olofos/servo-joystick/pwm.asc

R1: res; 46.25k
R2: res; 24k
R3: res; 100k
R4: res; 100k
R5: res; 33
R6: res; 1
U1: LTC6240
U2: LTC6240
V1: voltage; 5
V2: voltage; 5
V3: voltage; PULSE(1.5 3.5 0 0.012 0.012 1e-10 0.024 100)
Named nets: 0
.tran 100ms
