olofos/servo-joystick/servo-joystick.kicad_pcb

## KiCad design servo-joystick.kicad_pcb (2018-06-14)

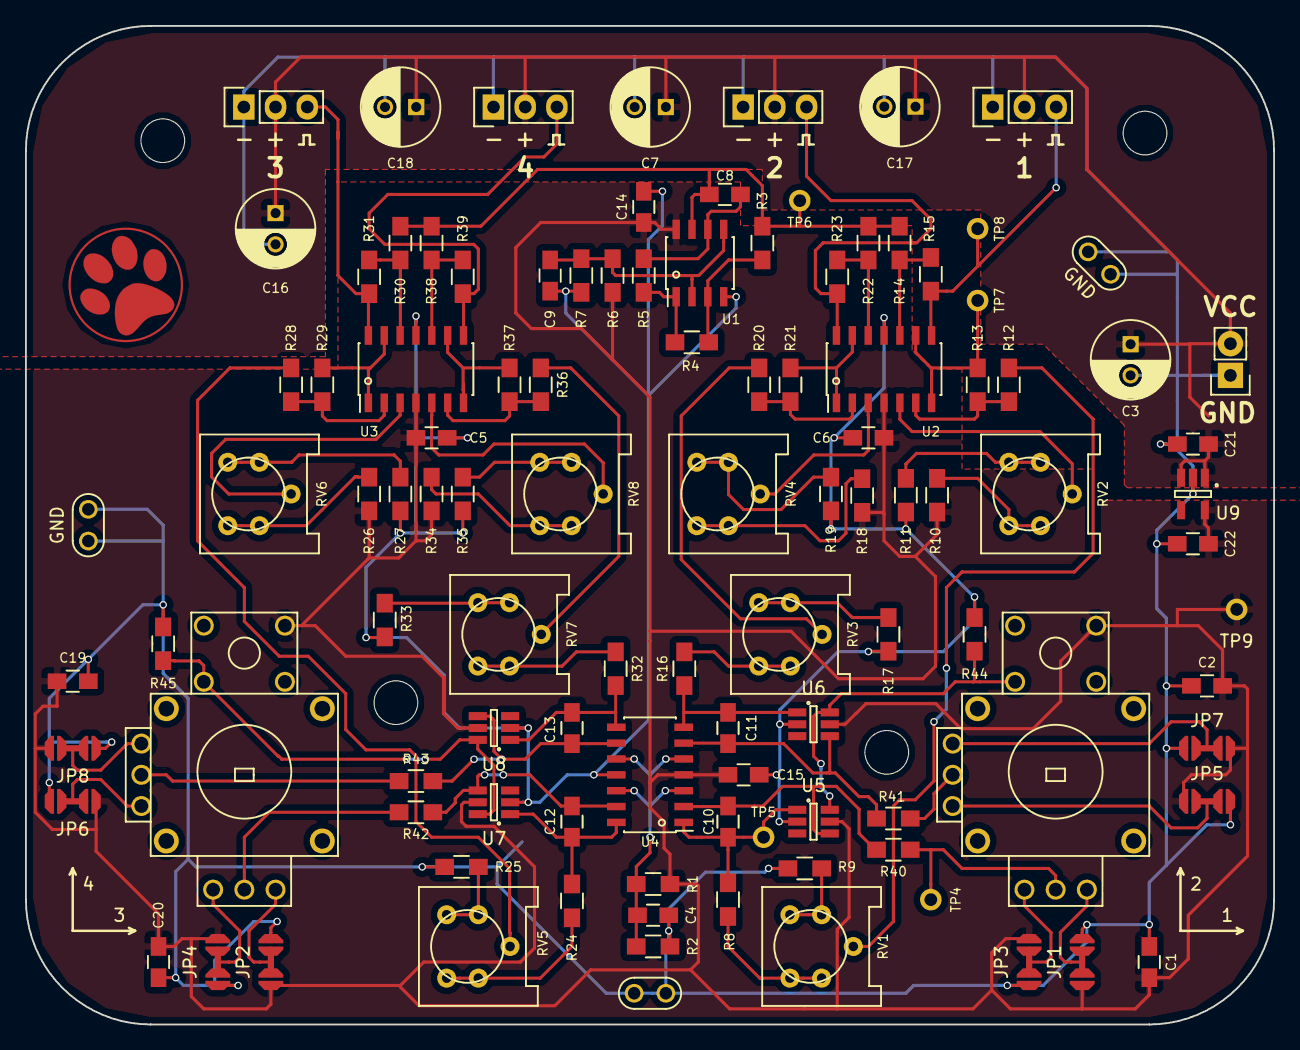
[picture p1: board servo-joystick.kicad_pcb from above]

Board: 2 copper layers, 100.0 x 80.0 mm, 112 parts (0 on the bottom side), 71 nets.

Parts:
C1, C2, C4, C5, C6, C9, C14, C15, C19, C20: 1u; C_0805_HandSoldering
C3, C7, C16, C17, C18: 100u; C_Radial_D6.3_L11.2_P2.5
C8, C10, C11, C12, C13: 100n; C_0805_HandSoldering
C21, C22: 2u2; C_0805_HandSoldering
JP1, JP2, JP3, JP4, JP5, JP6, JP7, JP8: JUMPER-3
MH6, MH6#2, MH6#3, MH6#4: MOUNTING_HOLE; MH-M3
P1: CONN_01X02; Pin_Header_Straight_1x02
P2, P3, P4, P5: CONN_01X03; Pin_Header_Straight_1x03
R1, R2, R3, R6, R7, R44, R45: 1k2; R_0805_HandSoldering
R4: 3k; R_0805_HandSoldering
R5, R12, R13, R15, R20, R21, R23, R28, R29, R31, R36, R37, R39: 150k; R_0805_HandSoldering
R8, R10, R16, R18, R24, R26, R32, R34: 30k; R_0805_HandSoldering
R9, R14, R17, R22, R25, R30, R33, R38: 470; R_0805_HandSoldering
R11, R19, R27, R35: 15k; R_0805_HandSoldering
R40, R41, R42, R43: 6M8; R_0805_HandSoldering
RV1, RV3, RV5, RV7: 100; Potentiometer_Bourns_3386P
RV2, RV4, RV6, RV8: 1k; Potentiometer_Bourns_3386P
TP1, TP2, TP3: GND; TEST_POINT_DOUBLE_TH
TP4: CTRL1; TEST_POINT_THD_NO_CIRC
TP5: INT1; TEST_POINT_THD_NO_CIRC
TP6: SAW; TEST_POINT_THD_NO_CIRC
TP7: BUF1; TEST_POINT_THD_NO_CIRC
TP8: PWM1; TEST_POINT_THD_NO_CIRC
TP9: VCC; TEST_POINT_THD_NO_CIRC
U1: MCP6002; SOIC-8_3.9x4.9mm_Pitch1.27mm
U2, U3, U4: MCP6004; SOIC-14_3.9x8.7mm_Pitch1.27mm
U5, U6, U7, U8: SN74LVC1G3157; SOT-23-6-Handsoldering
U9: LD2981; SOT-23-5-Handsoldering
VR1, VR2: JOYSTICK_SW; F-JM10K

Connections:
+6V: C3.1, C7.1, C16.1, C17.1, C18.1, C21.1, P1.2, P2.2, P3.2, P4.2, P5.2, U9.1, U9.3
/Integrator #1/INT_FB: C10.2, R40.1, U4.2, U5.4
/Integrator #1/SW: R44.2, U5.6, U6.6, VR1.7
/Integrator #1/VIN: R40.2, TP4.1, VR1.2
/Integrator #1/VREF: C4.1, R1.2, R2.1, U4.3, U4.5, U4.10, U4.12
/Integrator #2/INT_FB: C11.2, R41.1, U4.6, U6.4
/Integrator #2/VIN: R41.2, VR1.5
/Integrator #3/INT_FB: C12.2, R42.1, U4.13, U7.4
/Integrator #3/SW: R45.2, U7.6, U8.6, VR2.7
/Integrator #3/VIN: R42.2, VR2.2
/Integrator #4/INT_FB: C13.2, R43.1, U4.9, U8.4
/Integrator #4/VIN: R43.2, VR2.5
/PWM #1/BUF: R13.1, TP7.1, U2.7, U2.9
/PWM #1/BUF_IN: R12.1, R13.2, U2.6
/PWM #1/PWM: P2.3, R15.1, TP8.1, U2.8
/PWM #1/SAWTOOTH: C8.1, R3.2, R14.2, R22.2, R30.2, R38.2, TP6.1, U1.7
/PWM #1/SAW_P: R14.1, R15.2, U2.10
/PWM #1/VIN: C10.1, R8.1, TP5.1, U4.1, U5.1
/PWM #1/VIN_ADJ_M: R9.1, RV1.3
/PWM #1/VIN_ADJ_P: R8.2, RV1.1
/PWM #1/VIN_DIV: R12.2, RV1.2
/PWM #1/VREF: RV2.2, U2.5
/PWM #1/VREF_ADJ_M: R11.1, RV2.3
/PWM #1/VREF_ADJ_P: R10.2, RV2.1
/PWM #2/BUF: R21.1, U2.1, U2.13
/PWM #2/BUF_IN: R20.1, R21.2, U2.2
/PWM #2/PWM: P3.3, R23.1, U2.14
/PWM #2/SAW_P: R22.1, R23.2, U2.12
/PWM #2/VIN: C11.1, R16.1, U4.7, U6.1
/PWM #2/VIN_ADJ_M: R17.1, RV3.3
/PWM #2/VIN_ADJ_P: R16.2, RV3.1
/PWM #2/VIN_DIV: R20.2, RV3.2
/PWM #2/VREF: RV4.2, U2.3
/PWM #2/VREF_ADJ_M: R19.1, RV4.3
/PWM #2/VREF_ADJ_P: R18.2, RV4.1
/PWM #3/BUF: R29.1, U3.1, U3.13
/PWM #3/BUF_IN: R28.1, R29.2, U3.2
/PWM #3/PWM: P4.3, R31.1, U3.14
/PWM #3/SAW_P: R30.1, R31.2, U3.12
/PWM #3/VIN: C12.1, R24.1, U4.14, U7.1
/PWM #3/VIN_ADJ_M: R25.1, RV5.3
/PWM #3/VIN_ADJ_P: R24.2, RV5.1
/PWM #3/VIN_DIV: R28.2, RV5.2
/PWM #3/VREF: RV6.2, U3.3
/PWM #3/VREF_ADJ_M: R27.1, RV6.3
/PWM #3/VREF_ADJ_P: R26.2, RV6.1
/PWM #4/BUF: R37.1, U3.7, U3.9
/PWM #4/BUF_IN: R36.1, R37.2, U3.6
/PWM #4/PWM: P5.3, R39.1, U3.8
/PWM #4/SAW_P: R38.1, R39.2, U3.10
/PWM #4/VIN: C13.1, R32.1, U4.8, U8.1
/PWM #4/VIN_ADJ_M: R33.1, RV7.3
/PWM #4/VIN_ADJ_P: R32.2, RV7.1
/PWM #4/VIN_DIV: R36.2, RV7.2
/PWM #4/VREF: RV8.2, U3.5
/PWM #4/VREF_ADJ_M: R35.1, RV8.3
/PWM #4/VREF_ADJ_P: R34.2, RV8.1
/Sawtooth Wave/COMP_FB: R3.1, R4.2, U1.3
/Sawtooth Wave/COMP_OUT: R4.1, R5.1, U1.1
/Sawtooth Wave/INT_IN: C8.2, R5.2, U1.6
/Sawtooth Wave/VREF: C9.2, R6.1, R7.2, U1.2, U1.5
GND: C1.2, C2.2, C3.2, C4.2, C5.2, C6.2, C7.2, C9.1, C14.2, C15.2, C16.2, C17.2, C18.2, C19.2, C20.2, C21.2, C22.2, JP1.3, JP2.3, JP3.1, JP4.1, JP5.3, JP6.3, JP7.1, JP8.1, P1.1, P2.1, P3.1, P4.1, P5.1, R2.2, R7.1, R9.2, R11.2, R17.2, R19.2, R25.2, R27.2, R33.2, R35.2, R44.1, R45.1, TP1.1, TP2.1, TP3.1, U1.4, U2.11, U3.11, U4.11, U5.2, U6.2, U7.2, U8.2, U9.2
unnamed: JP1.2, VR1.1
unnamed: JP2.2, VR2.1
unnamed: JP3.2, VR1.3
unnamed: JP4.2, VR2.3
unnamed: JP5.2, VR1.4
unnamed: JP6.2, VR2.4
unnamed: JP7.2, VR1.6
unnamed: JP8.2, VR2.6
VCC: C1.1, C2.1, C5.1, C6.1, C14.1, C15.1, C19.1, C20.1, C22.1, JP1.1, JP2.1, JP3.3, JP4.3, JP5.1, JP6.1, JP7.3, JP8.3, R1.1, R6.2, R10.1, R18.1, R26.1, R34.1, TP9.1, U1.8, U2.4, U3.4, U4.4, U5.5, U6.5, U7.5, U8.5, U9.5, VR1.10, VR2.10
