olofos/servo-joystick/(commit log)

2017-11-16 initial import
    [PWM.sch, integrator.sch, saw-wave.sch, servo-joystick.kicad_pcb, servo-joystick.sch]
2018-06-10 Rev A
    [PWM.sch, integrator.sch, servo-joystick.kicad_pcb, servo-joystick.sch]
2018-06-11 Added 5V regulator
    [PWM.sch, integrator.sch, power.sch, saw-wave.sch, servo-joystick.sch]
2018-06-11 Added missing foorprint for C3
    [power.sch]
2018-06-12 Removed 0R resistors and started new layout
    [PWM.sch, integrator.sch, power.sch, saw-wave.sch, servo-joystick.kicad_pcb, servo-joystick.sch]
2018-06-13 Larger SOT-23-6 pads
    [servo-joystick.kicad_pcb]
2018-06-13 Larger SOT-23-5 pads
    [servo-joystick.kicad_pcb]
2018-06-13 Better solder jumper footprint
    [servo-joystick.kicad_pcb]
2018-06-14 Correct pinout for LD2981
    [servo-joystick.kicad_pcb]
2018-06-14 Fixed corner outline
    [servo-joystick.kicad_pcb]
